orkiman/glueGun8262_040126/myLibs/DRV8262DDWR/DRV8262DDWR.step

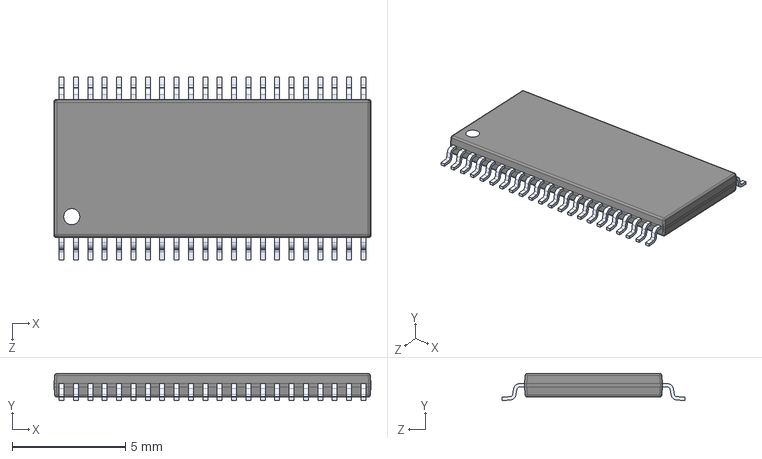
[picture p1: CAD file, 2026-01-04]
myLibs/DRV8262DDWR/DRV8262DDWR.step
14.0 x 1.20 x 8.10 mm
