orkiman/glueGun8262_040126/myLibs/ul_DRV8262DDWR (1)/DDW0044E.stp

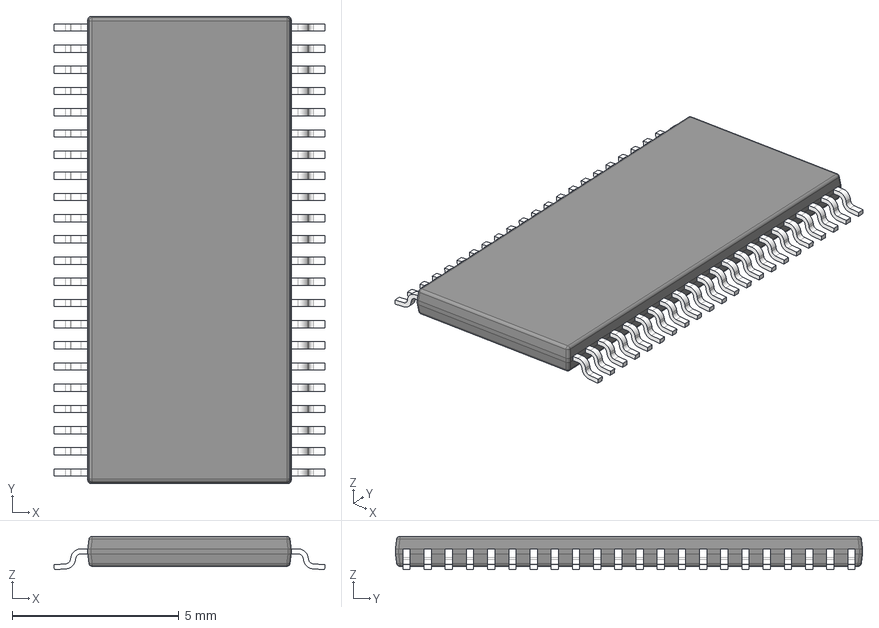
[picture p2: CAD file, 2026-01-04]
myLibs/ul_DRV8262DDWR (1)/DDW0044E.stp
8.12 x 14.0 x 1.00 mm
BODY-SO
LEAD-SO x 44
THERMALPAD-SO
