orkiman/glueGun8262_040126/glueGun8262_040126.kicad_pcb

## KiCad design glueGun8262_040126.kicad_pcb (2026-03-08)

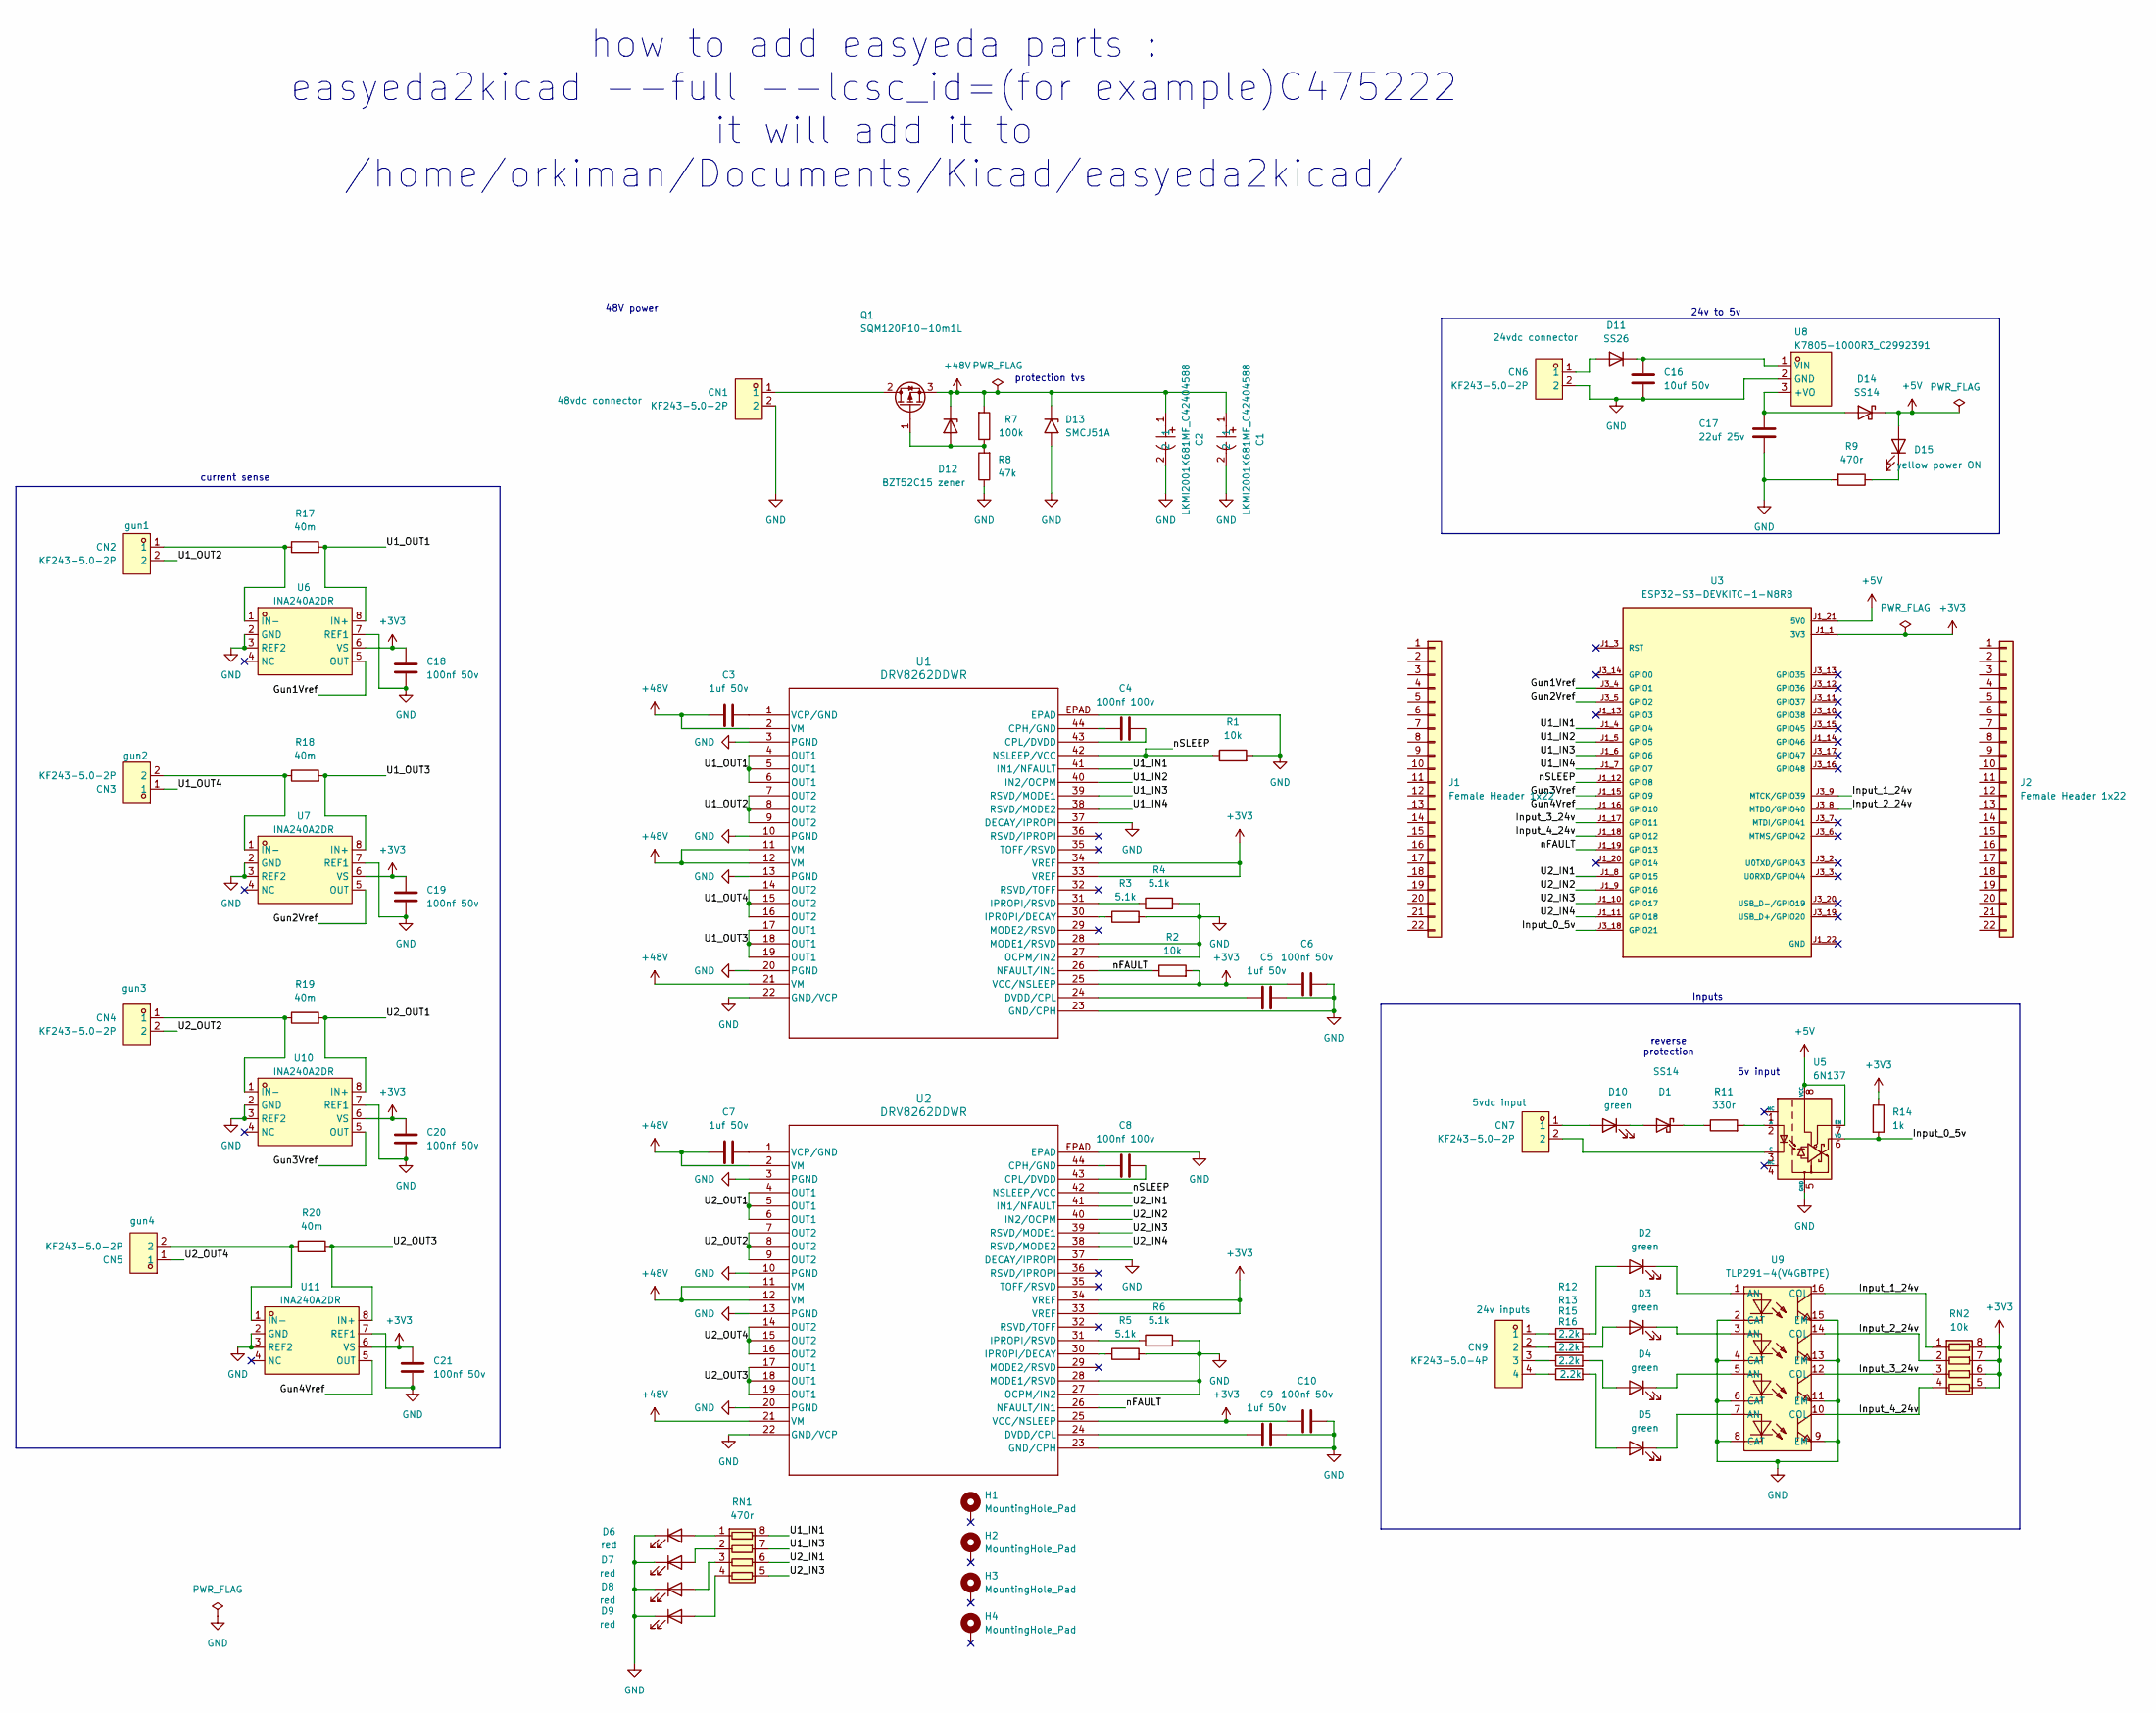
[picture p3: schematic glueGun8262_040126.kicad_sch]

Parts:
C1, C2: LKMI2001K681MF_C42404588; CAP-TH_BD16.0-P7.50-D0.8-FD; LCSC part C42404588
C3, C5, C7, C9: 1uf 50v; C_0603_1608Metric; lcsc C106248
C4, C8: 100nf 100v; C_0805_2012Metric; lcsc C113803
C6, C10: 100nf 50v; C_0603_1608Metric; lcsc C309458
C16: 10uf 50v; C_1206_3216Metric; lcsc C513774
C17: 22uf 25v; C_1206_3216Metric; lcsc C513771
C18, C19, C20, C21: 100nf 50v; C_0603_1608Metric; LCSC part C14663
CN1, CN2, CN3, CN4, CN5, CN6, CN7: KF243-5.0-2P; CONN-TH_P5.00_KF243-5.0-2P; LCSC part C475222
CN9: KF243-5.0-4P; CONN-TH_4P-P5.00_KF243-5.0-4P; LCSC part C475224
D1: SS14; D_SMA; part ss14; LCSC part C2480
D2, D3, D4, D5, D10: green; LED_0805_2012Metric; lcsc C2297
D6, D7, D8, D9: red; LED_0805_2012Metric; LCSC part C84256
D11: SS26; D_SMA; part ss26; LCSC part C14238
D12: BZT52C15 zener; D_SOD-123; LCSC part C2104
D13: SMCJ51A; D_SMC; LCSC part C438115
D14: SS14; D_SMA; LCSC part C2480
D15: yellow power ON; LED_0805_2012Metric; lcsc C2297
H1, H2, H3, H4: MountingHole_Pad; MountingHole_3.2mm_M3_Pad
J1, J2: Female Header 1x22; LCSC part C7499337
Q1: SQM120P10-10m1L; TO-263-2; LCSC part C3281565
R1, R2: 10k; R_0603_1608Metric; lcsc C84376
R3, R4, R5, R6: 5.1k; R_0603_1608Metric; LCSC part C23186
R7: 100k; R_0805_2012Metric; LCSC part C25611
R8: 47k; R_0805_2012Metric; LCSC part C17713
R9: 470r; R_0603_1608Metric; LCSC part C23179
R11: 330r; R_0603_1608Metric; LCSC part C23138
R12, R13, R15, R16: 2.2k; R_1206_3216Metric; LCSC part C17948
R14: 1k; R_0603_1608Metric; LCSC part C21190
R17, R18, R19, R20: 40m; R_2512_6332Metric; lcsc C500722
RN1: 470r; R_Array_Convex_4x0603; LCSC part C354986
RN2: 10k; R_Array_Convex_4x0603; LCSC part C107374
U1, U2: DRV8262DDWR; HTSSOP44-DDW_TEX
U3: ESP32-S3-DEVKITC-1-N8R8; XCVR_ESP32-S3-DEVKITC-1-N8R2; PARTREV V1
U5: 6N137; SMDIP-8_W9.53mm; LCSC part C16496
U6, U7, U10, U11: INA240A2DR; SOIC-8_L4.9-W3.9-P1.27-LS6.0-BL; LCSC part C2060768
U8: K7805-1000R3_C2992391; PWRM-TH_YLPTEC_K78XX-1000R3; LCSC part C2992391
U9: TLP291-4(V4GBTPE); SOP-16_L10.3-W4.4-P1.27-LS7.0-BL; LCSC part C2848503

Connections:
+3V3: C6.1, C10.1, C18.1, C19.1, C20.1, C21.1, R2.2, R14.1, RN2.5 (R4.2), RN2.6 (R3.2), RN2.7 (R2.2), RN2.8 (R1.2), U1.25 (VCC/NSLEEP), U1.33 (VREF), U1.34 (VREF), U2.25 (VCC/NSLEEP), U2.33 (VREF), U2.34 (VREF), U3.J1_1 (3V3), U3.J1_2 (3V3), U6.6 (VS), U7.6 (VS), U10.6 (VS), U11.6 (VS)
+5V: D14.1 (K), D15.2 (A), U3.J1_21 (5V0), U5.7 (EN), U5.8 (VCC)
+48V: C1.1, C2.1, C3.1, C7.1, D12.1 (K), D13.1 (A1), Q1.3 (S), R7.2, U1.2 (VM), U1.11 (VM), U1.12 (VM), U1.21 (VM), U2.2 (VM), U2.11 (VM), U2.12 (VM), U2.21 (VM)
/Gun1Vref: U3.J3_4 (GPIO1), U6.5 (OUT)
/Gun2Vref: U3.J3_5 (GPIO2), U7.5 (OUT)
/Gun3Vref: U3.J1_15 (GPIO9), U10.5 (OUT)
/Gun4Vref: U3.J1_16 (GPIO10), U11.5 (OUT)
/Input_0_5v: R14.2, U3.J3_18 (GPIO21), U5.6 (VO)
/Input_1_24v: RN2.1 (R1.1), U3.J3_9 (MTCK/GPIO39), U9.16 (COL)
/Input_2_24v: RN2.2 (R2.1), U3.J3_8 (MTDO/GPIO40), U9.14 (COL)
/Input_3_24v: RN2.3 (R3.1), U3.J1_17 (GPIO11), U9.12 (COL)
/Input_4_24v: RN2.4 (R4.1), U3.J1_18 (GPIO12), U9.10 (COL)
/U1_IN1: RN1.8 (R1.2), U1.41 (IN1/NFAULT), U3.J1_4 (GPIO4)
/U1_IN2: U1.40 (IN2/OCPM), U3.J1_5 (GPIO5)
/U1_IN3: RN1.7 (R2.2), U1.39 (RSVD/MODE1), U3.J1_6 (GPIO6)
/U1_IN4: U1.38 (RSVD/MODE2), U3.J1_7 (GPIO7)
/U1_OUT1: R17.2, U1.4 (OUT1), U1.5 (OUT1), U1.6 (OUT1), U6.8 (IN+)
/U1_OUT2: CN2.2, U1.7 (OUT2), U1.8 (OUT2), U1.9 (OUT2)
/U1_OUT3: R18.2, U1.17 (OUT1), U1.18 (OUT1), U1.19 (OUT1), U7.8 (IN+)
/U1_OUT4: CN3.1, U1.14 (OUT2), U1.15 (OUT2), U1.16 (OUT2)
/U2_IN1: RN1.6 (R3.2), U2.41 (IN1/NFAULT), U3.J1_8 (GPIO15)
/U2_IN2: U2.40 (IN2/OCPM), U3.J1_9 (GPIO16)
/U2_IN3: RN1.5 (R4.2), U2.39 (RSVD/MODE1), U3.J1_10 (GPIO17)
/U2_IN4: U2.38 (RSVD/MODE2), U3.J1_11 (GPIO18)
/U2_OUT1: R19.2, U2.4 (OUT1), U2.5 (OUT1), U2.6 (OUT1), U10.8 (IN+)
/U2_OUT2: CN4.2, U2.7 (OUT2), U2.8 (OUT2), U2.9 (OUT2)
/U2_OUT3: R20.2, U2.17 (OUT1), U2.18 (OUT1), U2.19 (OUT1), U11.8 (IN+)
/U2_OUT4: CN5.1, U2.14 (OUT2), U2.15 (OUT2), U2.16 (OUT2)
/nFAULT: R2.1, U1.26 (NFAULT/IN1), U2.26 (NFAULT/IN1), U3.J1_19 (GPIO13)
/nSLEEP: R1.1, U1.42 (NSLEEP/VCC), U2.42 (NSLEEP/VCC), U3.J1_12 (GPIO8)
unnamed: CN9.1, R12.1
unnamed: CN9.2, R13.1
unnamed: CN9.3, R15.1
unnamed: CN9.4, R16.1
unnamed: D1.2 (A), D10.1 (K)
unnamed: D1.1 (K), R11.1
unnamed: D2.2 (A), R12.2
unnamed: D2.1 (K), U9.1 (AN)
unnamed: D3.2 (A), R13.2
unnamed: D3.1 (K), U9.3 (AN)
unnamed: D4.2 (A), R15.2
unnamed: D4.1 (K), U9.5 (AN)
unnamed: D5.2 (A), R16.2
unnamed: D5.1 (K), U9.7 (AN)
unnamed: D6.2 (A), RN1.1 (R1.1)
unnamed: D7.2 (A), RN1.2 (R2.1)
unnamed: D8.2 (A), RN1.3 (R3.1)
unnamed: D9.2 (A), RN1.4 (R4.1)
unnamed: CN7.1, D10.2 (A)
unnamed: CN6.1, D11.2 (A)
unnamed: C16.1, D11.1 (K), U8.1 (VIN)
unnamed: D12.2 (A), Q1.1 (G), R7.1, R8.2
unnamed: C17.1, D14.2 (A), U8.3 (+VO)
unnamed: D15.1 (K), R9.1
unnamed: CN1.1, Q1.2 (D)
unnamed: C4.1, U1.44 (CPH/GND)
unnamed: C4.2, U1.43 (CPL/DVDD)
unnamed: C5.1, U1.24 (DVDD/CPL)
unnamed: R3.1, U1.30 (IPROPI/DECAY)
unnamed: R4.1, U1.31 (IPROPI/RSVD)
unnamed: C3.2, U1.1 (VCP/GND)
unnamed: C8.1, U2.44 (CPH/GND)
unnamed: C8.2, U2.43 (CPL/DVDD)
unnamed: C9.1, U2.24 (DVDD/CPL)
unnamed: R5.1, U2.30 (IPROPI/DECAY)
unnamed: R6.1, U2.31 (IPROPI/RSVD)
unnamed: C7.2, U2.1 (VCP/GND)
unnamed: R11.2, U5.2 (A)
unnamed: CN7.2, U5.3 (C)
unnamed: CN2.1, R17.1, U6.1 (IN-)
unnamed: CN3.2, R18.1, U7.1 (IN-)
unnamed: CN4.1, R19.1, U10.1 (IN-)
unnamed: CN5.2, R20.1, U11.1 (IN-)

Notes on the sheet:
48V power
Inputs
reverse protection
how to add easyeda parts : easyeda2kicad --full --lcsc_id=(for example)C475222 it will add it to /home/orkiman/Documents/Kicad/easyeda2kicad/
24v to 5v
current sense
5v input
protection tvs

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
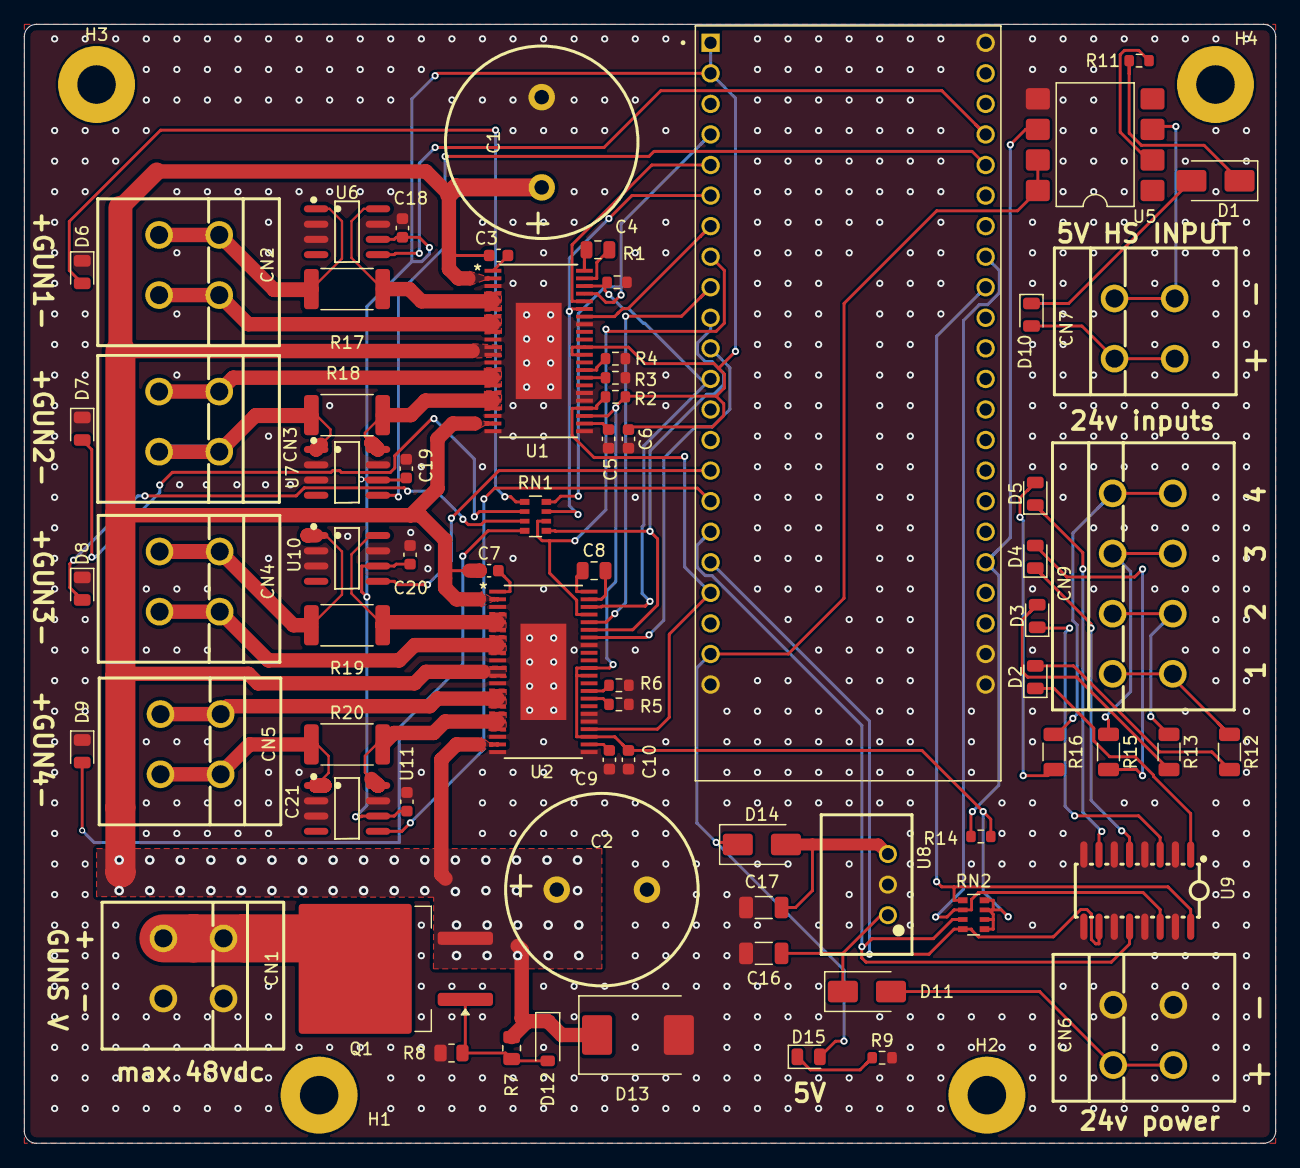
[picture p4: board glueGun8262_040126.kicad_pcb from above]

Board: 2 copper layers, 104.0 x 93.0 mm, 75 parts (0 on the bottom side), 74 nets.
