orkiman/glueGun8262_040126/(commit log)

2026-01-04 Initial commit: ESP32-S3 and DRV8262 project setup
    [DDW0044E.stp, DRV8262DDWR.step, glueGun8262_040126.kicad_pcb, glueGun8262_040126.kicad_sch]
2026-01-09 ina240 schunts in series with sol
    [glueGun8262_040126.kicad_pcb, glueGun8262_040126.kicad_sch]
2026-01-11 satrted laying pcb
    [glueGun8262_040126.kicad_pcb]
2026-01-12 cont arranging board. and easyeda models now in project folder
    [glueGun8262_040126.kicad_pcb, glueGun8262_040126.kicad_sch]
2026-01-13 in the process of changing 0402 to 0603 footprints
    [glueGun8262_040126.kicad_pcb]
2026-01-14 cont rearrange pcb
    [glueGun8262_040126.kicad_pcb, glueGun8262_040126.kicad_sch]
2026-01-17 high power routed and locked
    [glueGun8262_040126.kicad_pcb, glueGun8262_040126.kicad_sch]
2026-01-18 no drc errors1
    [glueGun8262_040126.kicad_pcb]
2026-01-18 no drcErrors2 before replacing U5 to smt
    [glueGun8262_040126.kicad_pcb]
2026-01-20 added mounting holes
    [glueGun8262_040126.kicad_pcb, glueGun8262_040126.kicad_sch]
2026-01-21 no drc errors with mounting holes
    [glueGun8262_040126.kicad_pcb, glueGun8262_040126.kicad_sch]
2026-01-25 add protection schotoky diode to 5v supply
    [glueGun8262_040126.kicad_pcb]
2026-02-05 schematics updated pinout
    [glueGun8262_040126.kicad_sch]
2026-02-08 pcb rewired new pinout
    [glueGun8262_040126.kicad_pcb, glueGun8262_040126.kicad_sch]
2026-02-08 no drc errors
    [glueGun8262_040126.kicad_pcb, glueGun8262_040126.kicad_sch]
2026-02-26 Ignore KiCad autosave file
2026-02-28 redesigned before freerouting
    [glueGun8262_040126.kicad_pcb, glueGun8262_040126.kicad_sch]
2026-03-03 minor mounting hole position mostly git test
    [glueGun8262_040126.kicad_pcb]
2026-03-03 minor relocation
    [glueGun8262_040126.kicad_pcb]
2026-03-05 redesign rectanglular board routed no errors
    [glueGun8262_040126.kicad_pcb, glueGun8262_040126.kicad_sch]
2026-03-05 bulk cap rotated
    [glueGun8262_040126.kicad_pcb]
2026-03-05 cap place correction
    [glueGun8262_040126.kicad_pcb]
2026-03-07 dont remember
    [glueGun8262_040126.kicad_pcb]
2026-03-07 footprintes updated for home desktop
    [glueGun8262_040126.kicad_pcb]
2026-03-07 leds position at the correct locations
    [glueGun8262_040126.kicad_pcb, glueGun8262_040126.kicad_sch]
2026-03-07 start to assign footprints
    [glueGun8262_040126.kicad_sch]
2026-03-07 almost done find lcsc parts
    [glueGun8262_040126.kicad_pcb, glueGun8262_040126.kicad_sch]
2026-03-08 before adding headers
    [glueGun8262_040126.kicad_pcb, glueGun8262_040126.kicad_sch]
2026-03-08 design done
    [glueGun8262_040126.kicad_pcb, glueGun8262_040126.kicad_sch]
2026-03-08 incresed 48v clearance to 0.3
    [glueGun8262_040126.kicad_pcb]
2026-03-11 Update .gitignore for KiCad 9 and UI settings
